yergefoltz/ERC-2026-Power-Mux-Board-Xplore/Basic_Mux.kicad_pcb

## KiCad design Basic_Mux.kicad_pcb (2026-11-11)

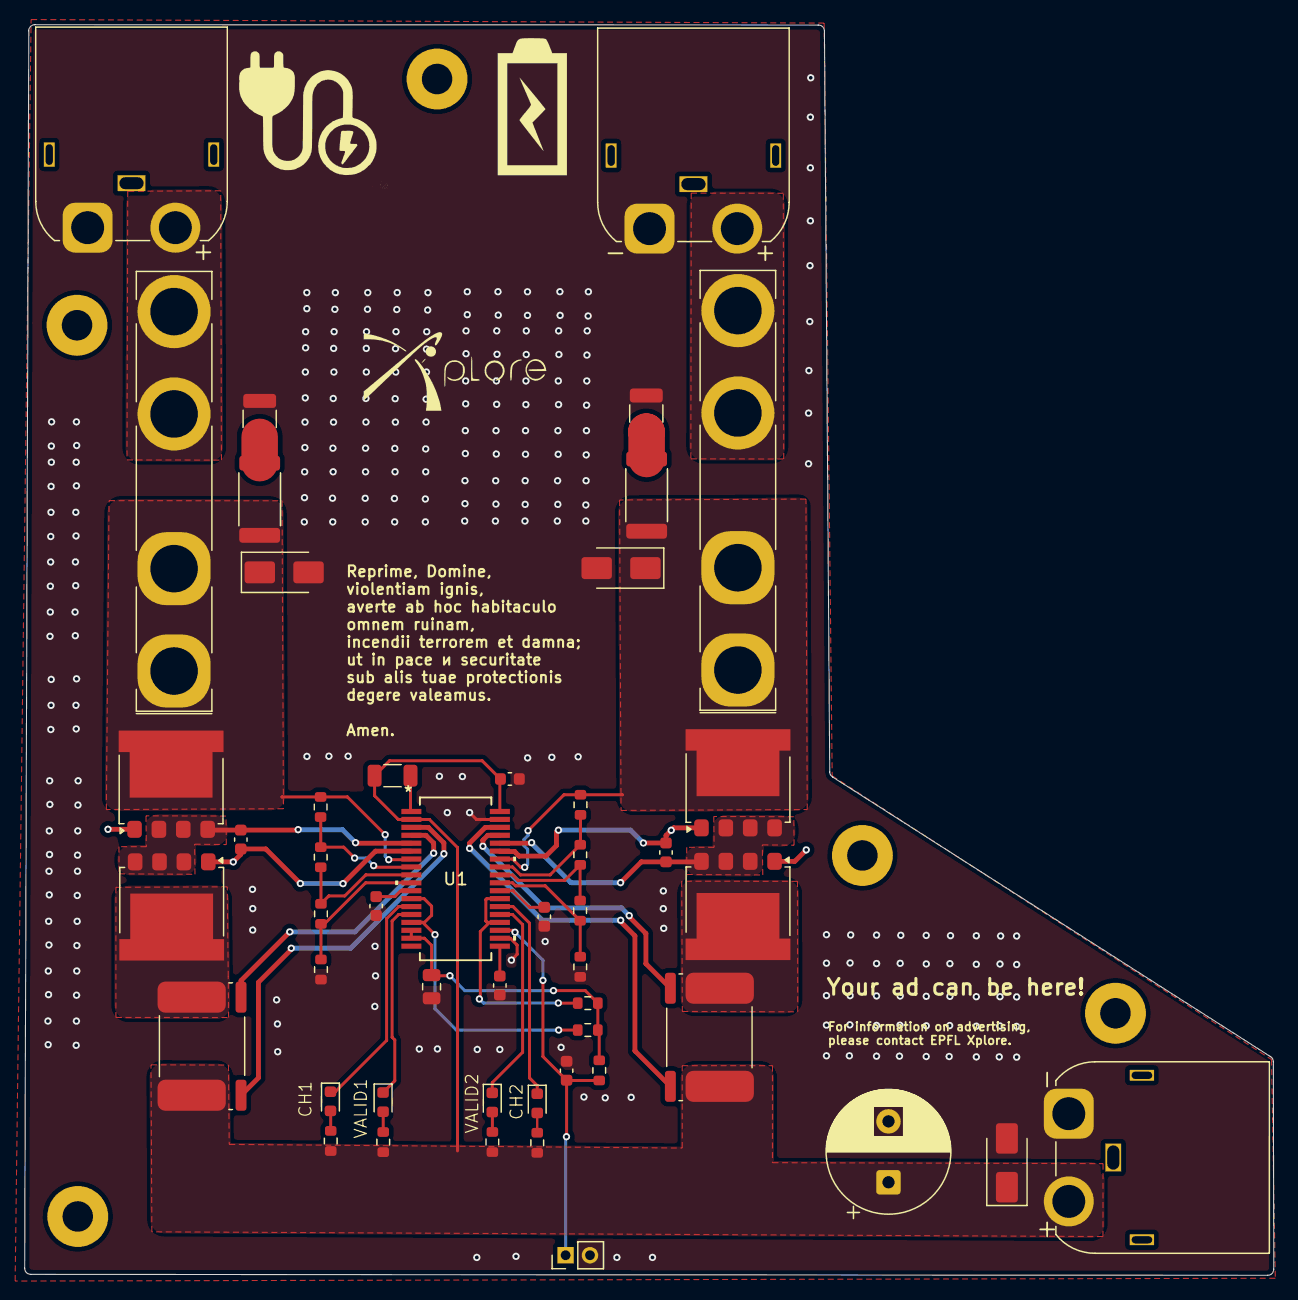
[picture p1: board Basic_Mux.kicad_pcb from above]

Board: 4 copper layers, 102.5 x 102.6 mm, 54 parts (0 on the bottom side), 40 nets.

Parts:
C1, C2: 10uF; C_1210_3225Metric
C4, C7: 47nF; C_0603_1608Metric
C5: 2.2uF; C_1206_3216Metric
C6: 220uF; CP_Radial_D10.0mm_P5.00mm
C8: 0.1uF; C_0603_1608Metric
C9: 3.3nF; C_0603_1608Metric
C10, C11: 10nF; C_0603_1608Metric
C12: 2.7uF; C_0805_2012Metric
C13: 100nF; C_0603_1608Metric
D1, D3, D4, D6: LED; LED_0603_1608Metric
D7, D8, D9: SMCJ33A; D_SMA
F1, F2: 40A; Fuseholder_Keystone_3555-2
H7, H9, H10, H11, H12: MountingHole_Pad; MountingHole_2.5mm_Pad
J1, J2: XT60PW_M; AMASS_XT60IPW-M_1x03_P7.20mm_Horizontal
J3: XT60PW_F; AMASS_XT60IPW-M_1x03_P7.20mm_Horizontal
J4: Conn_01x02; PinHeader_1x02_P2.00mm_Vertical
Q1, Q2, Q3, Q4: SQJQ184E; LFPAK88
R1, R2: 0.47; R_2512_6332Metric
R3, R4: 0.4m; R_Shunt_Isabellenhuette_BVR4026
R5, R9: 976k; R_0603_1608Metric
R6: 825; R_0603_1608Metric
R7: 5.76k; R_0603_1608Metric
R8, R12: 14.3k; R_0603_1608Metric
R10: 3.01k; R_0603_1608Metric
R11: 6.49k; R_0603_1608Metric
R13, R14, R16, R17: 27k; R_0603_1608Metric
R15, R18, R19: 100k; R_0603_1608Metric
U1: LTC4421CG-PBF; G_05-08-1640_ADI

Connections:
+V_Cable: D7.1 (A1), F2.1, Q3.5 (D), R1.2, R5.1, U1.7 (V1)
+V_battery: D8.1 (A1), F1.1, Q4.5 (D), R2.2, R9.1, U1.30 (V2)
+V_output: C5.1, C6.1, C8.2, D9.1 (A1), J3.2, R3.4, R4.1, R13.2, R14.2, R16.2, R17.2, U1.2 (CPOREF), U1.36 (EXTVCC)
/LTC_controller/CH1: D6.1 (K), U1.13 (*CH1)
/LTC_controller/CH2: D3.1 (K), U1.24 (*CH2)
/LTC_controller/CPO: C5.2, U1.1 (CPO)
/LTC_controller/Gate1: C4.1, Q1.1 (G), Q3.1 (G), U1.6 (GATE1)
/LTC_controller/Gate2: C7.1, Q2.1 (G), Q4.1 (G), U1.31 (GATE2)
/LTC_controller/OV1: R7.2, R8.1, U1.10 (OV1)
/LTC_controller/OV2: R11.2, R12.1, U1.27 (OV2)
/LTC_controller/Out1: R4.2, U1.3 (OUT1)
/LTC_controller/Out2: R3.3, U1.34 (OUT2)
/LTC_controller/Sense1: R4.3, U1.4 (SENSE1)
/LTC_controller/Sense2: R3.2, U1.33 (SENSE2)
/LTC_controller/Source2: C7.2, Q2.2 (S), Q2.3 (S), Q2.4 (S), Q4.2 (S), Q4.3 (S), Q4.4 (S), U1.32 (SOURCE2)
/LTC_controller/TO_INT: C12.2, R15.2, R18.1, R19.2, U1.16 (CASIN), U1.17 (INTVCC)
/LTC_controller/UVF1: R5.2, R6.1, U1.8 (UVF1)
/LTC_controller/UVF2: R9.2, R10.1, U1.29 (UVF2)
/LTC_controller/UVR1: R6.2, R7.1, U1.9 (UVR1)
/LTC_controller/UVR2: R10.2, R11.1, U1.28 (UVR2)
/LTC_controller/VALID1: D1.1 (K), U1.14 (*VALID1)
/LTC_controller/VALID2: D4.1 (K), U1.23 (*VALID2)
GND: C1.1, C2.1, C6.2, C8.1, C9.1, C10.1, C11.1, C12.1, C13.1, D7.2 (A2), D8.2 (A2), D9.2 (A2), J1.1, J2.1, J3.1, J4.2, R8.2, R12.2, U1.20 (RETRY), U1.35 (GND)
unnamed: C1.2, R1.1
unnamed: C2.2, R2.1
unnamed: D1.2 (A), R14.1
unnamed: D3.2 (A), R16.1
unnamed: D4.2 (A), R17.1
unnamed: D6.2 (A), R13.1
unnamed: F2.2, J1.2
unnamed: F1.2, J2.2
unnamed: C13.2, J4.1, R19.1, U1.21 (*SHDN)
unnamed: Q1.5 (D), R4.4
unnamed: Q2.5 (D), R3.1
unnamed: R18.2, U1.12 (*DISABLE1), U1.15 (*FAULT1)
unnamed: R15.1, U1.22 (*FAULT2), U1.25 (*DISABLE2)
unnamed: C9.2, U1.19 (QUAL)
unnamed: C4.2, Q1.2 (S), Q1.3 (S), Q1.4 (S), Q3.2 (S), Q3.3 (S), Q3.4 (S), U1.5 (SOURCE1)
unnamed: C11.2, U1.11 (TMR1)
unnamed: C10.2, U1.26 (TMR2)
